ZOUDIO/stabielator/Renders/wit/stabilisator_behuizing_onderkant_(Assembly)_2026-Aug-31_06-38-13PM-000_CustomizedView34296426555.png

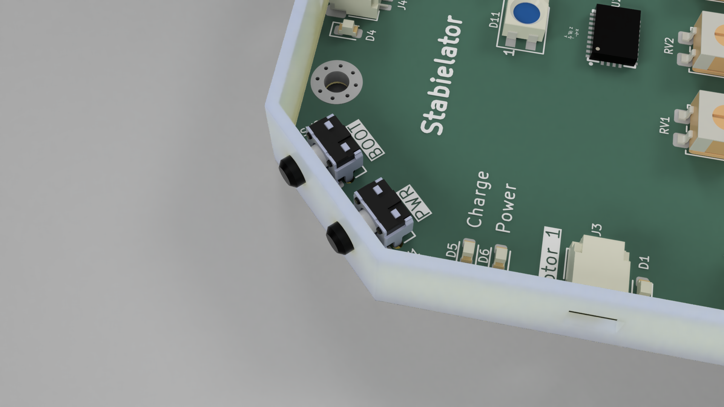
Renders/wit/stabilisator_behuizing_onderkant_(Assembly)_2026-Aug-31_06-38-13PM-000_CustomizedView34296426555.png
