ZOUDIO/stabielator/Renders/zwart/stabilisator_behuizing_onderkant_(Assembly)_2026-Sep-01_04-06-38PM-000_CustomizedView3394416120.png

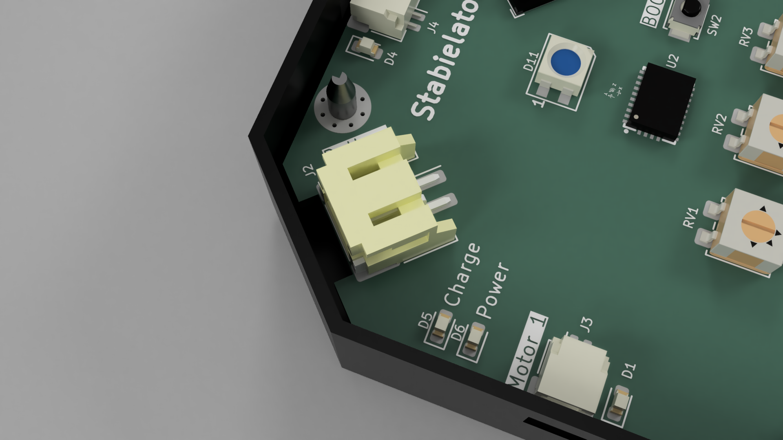
Renders/zwart/stabilisator_behuizing_onderkant_(Assembly)_2026-Sep-01_04-06-38PM-000_CustomizedView3394416120.png
