ZOUDIO/stabielator/Stabielator-Code-V1/README.md

<!--
@file README.md
@brief Startpunt voor de korte Stabielator-documentatie.
@date 2026-11-09
@author ProtoIoT Wietse Houwers
@note Prototype software for evaluation use only.
-->

# Stabielator-documentatie

Firmware **0.5.2** - bijgewerkt op **9 november 2026**.

- [Gebruiksaanwijzing](gebruiksaanwijzing.md): aansluiten, instellen en gebruiken.
- [Uitleg over de code](code-uitleg.md): hoe de software werkt en waar onderdelen staan.
- [Verschillen met het plan van aanpak](verschillen-plan-van-aanpak.md): gemaakte keuzes, aanvullingen en de reden daarvan.
- [Plan van aanpak v0.1](<Plan van Aanpak FW Stabielator v0.1.pdf>): het oorspronkelijke plan van 6 oktober 2026.

De vergelijking is gebaseerd op dit plan van aanpak.
