ZOUDIO/stabielator/Stabielator-Code-V1/Handleiding-Stabielator-firmware-bijwerken.pdf

# Firmware bijwerken

## 1 Open Geavanceerd

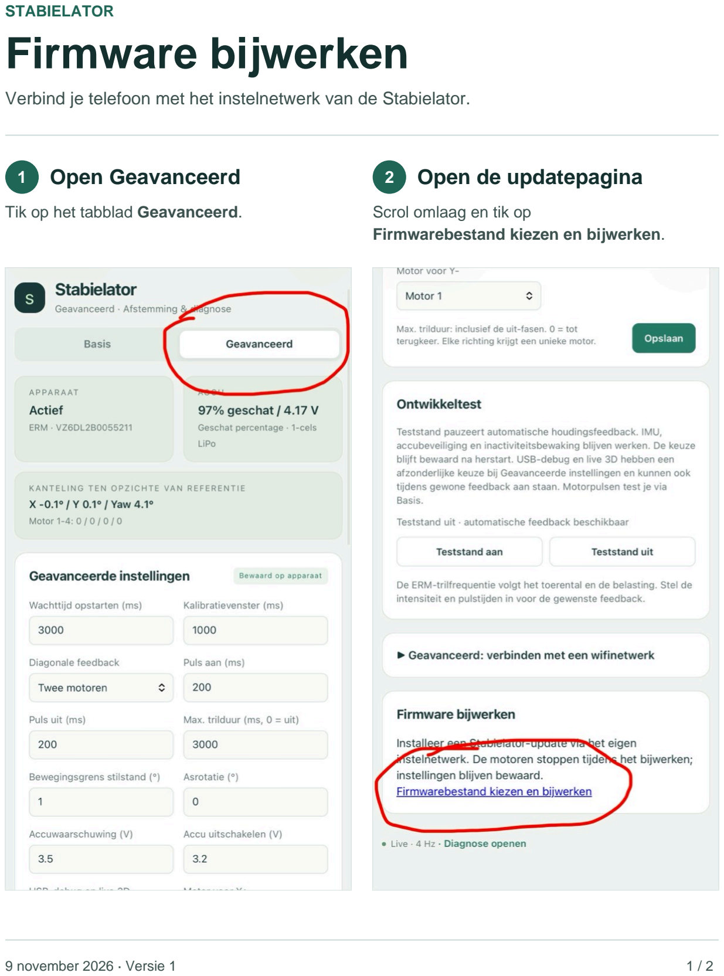
[picture p4: page 1]

STABIELATOR

Verbind je telefoon met het instelnetwerk van de Stabielator.

Tik op het tabblad Geavanceerd.

## 2 Open de updatepagina

Scrol omlaag en tik op
Firmwarebestand kiezen en bijwerken.
9 november 2026 · Versie 1 | 1 / 2

# Firmware bijwerken

## 3 Kies het firmwarebestand

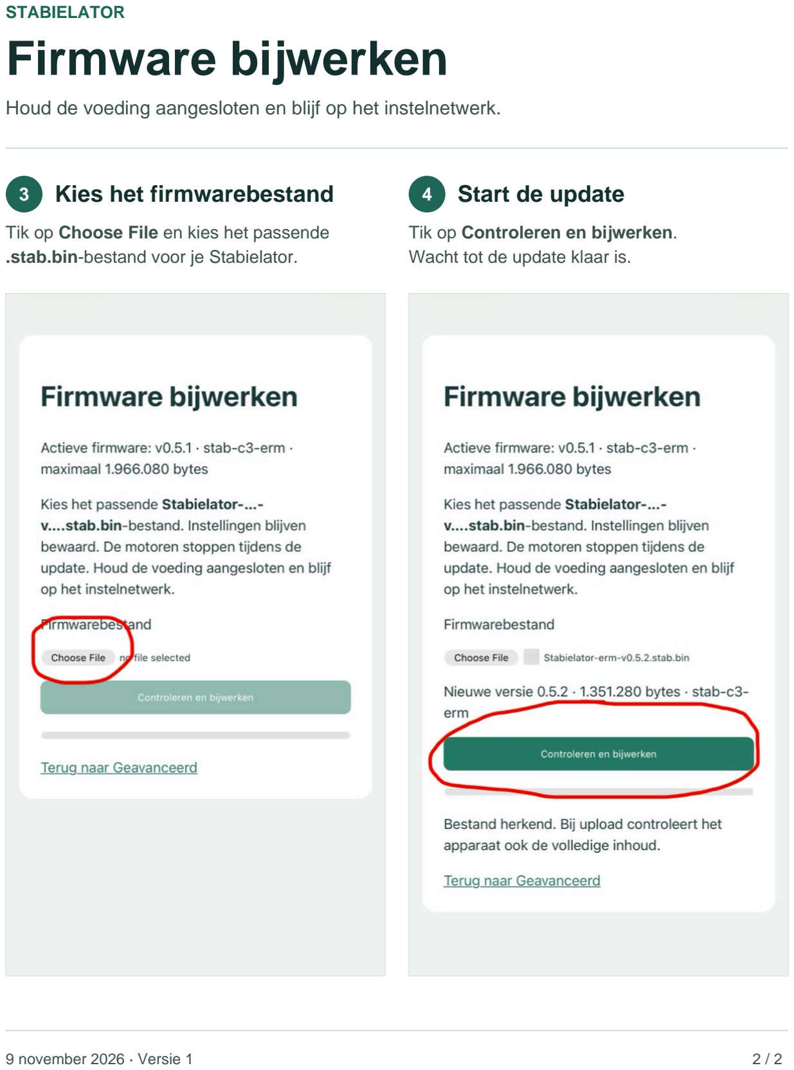
[picture p5: page 2]

STABIELATOR

Houd de voeding aangesloten en blijf op het instelnetwerk.

Tik op Choose File en kies het passende .stab.bin-bestand voor je Stabielator.

## 4 Start de update

Tik op Controleren en bijwerken. Wacht tot de update klaar is.

9 november 2026 · Versie 1 | 2 / 2
