ZOUDIO/stabielator/Renders/wit/83928c85-2367-4ab3-a8cb-f98133e98fb7.PNG

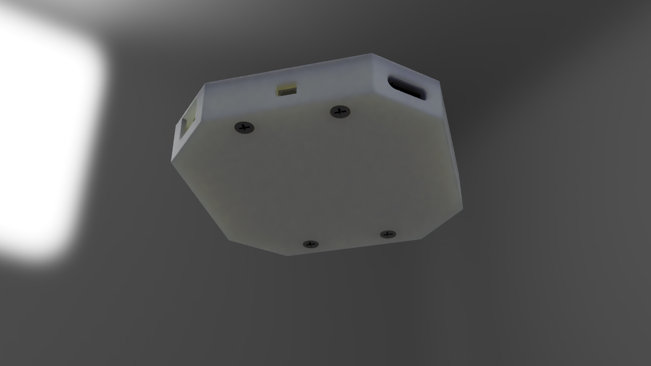
Renders/wit/83928c85-2367-4ab3-a8cb-f98133e98fb7.PNG
