ZOUDIO/stabielator/Renders/zwart/Screenshot 2026-09-01 180344.png

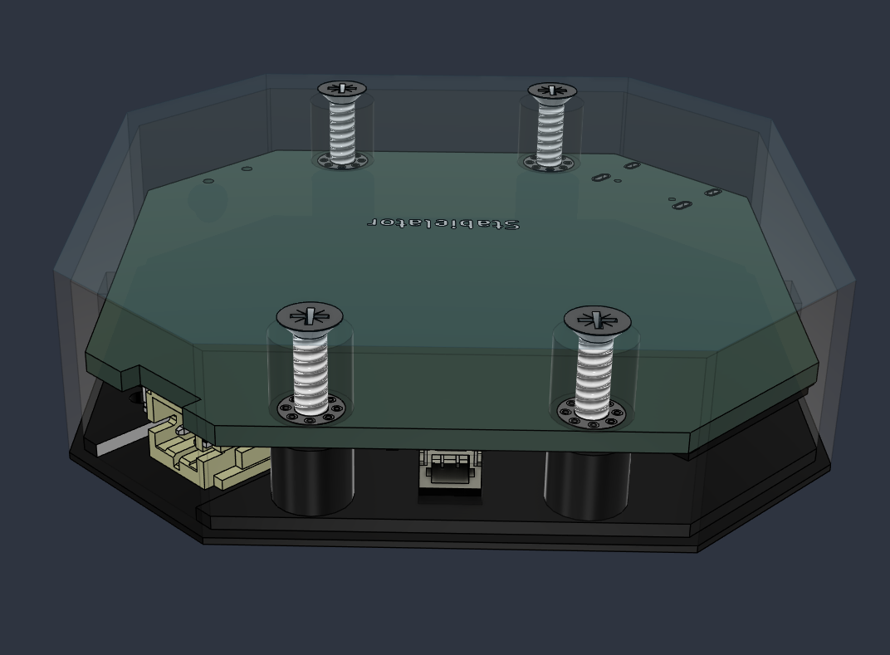
Renders/zwart/Screenshot 2026-09-01 180344.png
