ZOUDIO/stabielator/Behuizing/stabielator_pcb.step

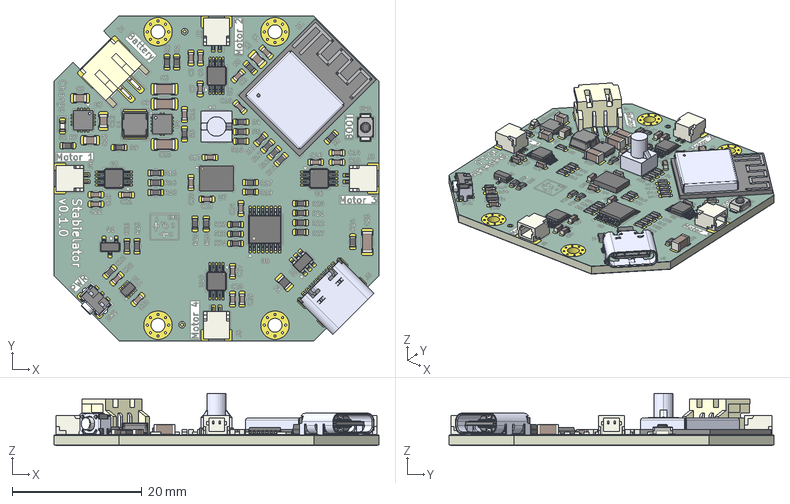
[picture p9: CAD file, 2026-11-09]
Behuizing/stabielator_pcb.step
50.0 x 50.0 x 8.02 mm
R_0603_1608Metric x 32
RGT16
C_0603_1608Metric x 22
TSSOP-10_3x3mm_P0.5mm x 4
TSSOP-16_4.4x5mm_P0.65mm
JST_SH_SM02B-SRSS-TB_1x02-1MP_P1.00mm_Horizontal x 4
C_0805_2012Metric x 4
ESP32-C3-MINI-1-N4
S2B-PH-SM4-TB(LF)(SN)
SOT-583-8
SKRTLAE010
SW_SPST_B3U-1000P
USB4105GFA_USB4105GFA
C_1206_3216Metric x 4
LED_0603_1608Metric
SOT-23
DRC10
SOT-23-6
Fuse_0805_2012Metric
L_Bourns-SRN4018
LED_RGB_Wuerth-PLCC4_3.2x2.8mm_150141M173100
LGA_28_52x38mm_P05mm
stabielator_copper
stabielator_silkscreen x 2
stabielator_soldermask x 2
stabielator_PCB
