ZOUDIO/stabielator/Behuizing/stabilisator_behuizing_knopje.step

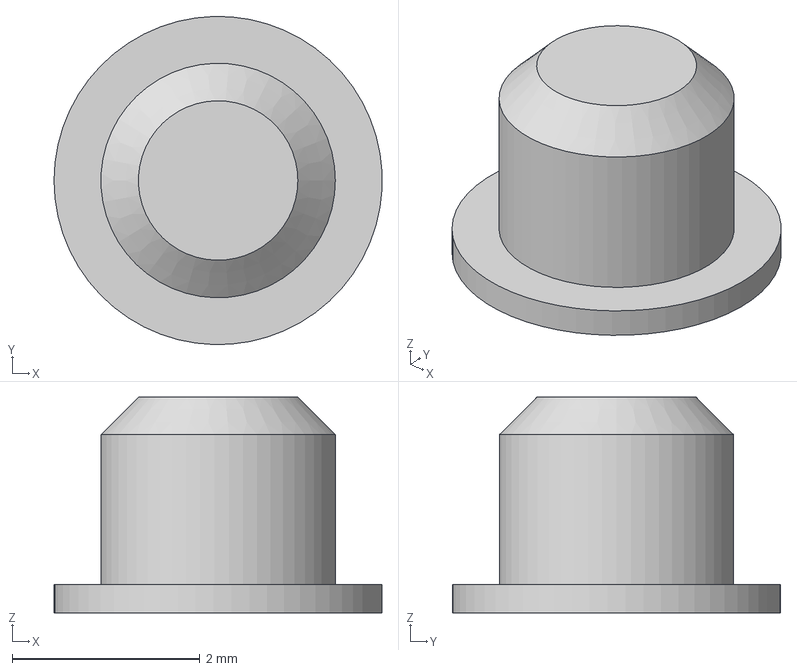
[picture p11: CAD file, 2026-09-01]
Behuizing/stabilisator_behuizing_knopje.step
3.50 x 3.50 x 2.30 mm
