ZOUDIO/stabielator/Behuizing/stabilisator_behuizing_onderkant.step

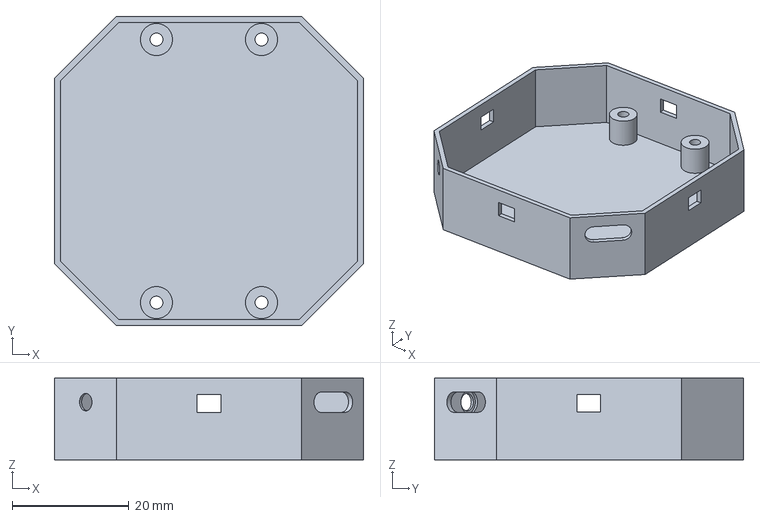
[picture p12: CAD file, 2026-09-01]
Behuizing/stabilisator_behuizing_onderkant.step
53.0 x 53.0 x 14.0 mm
