ZOUDIO/stabielator/Behuizing/stabilisator_behuizing_bovenkant.step

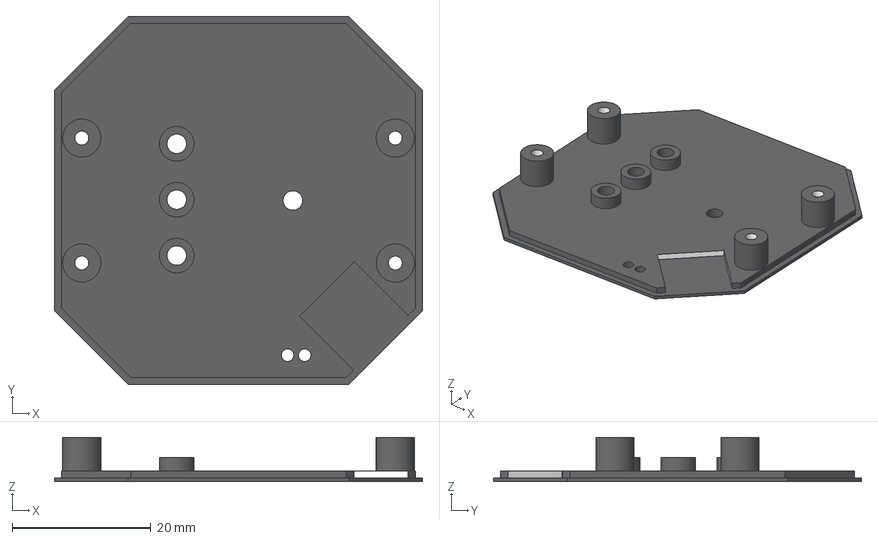
[picture p13: CAD file, 2026-09-01]
Behuizing/stabilisator_behuizing_bovenkant.step
53.0 x 53.0 x 6.38 mm
