ZOUDIO/stabielator/Behuizing/stabilisator_behuizing_bovenkant_TEST.dxf

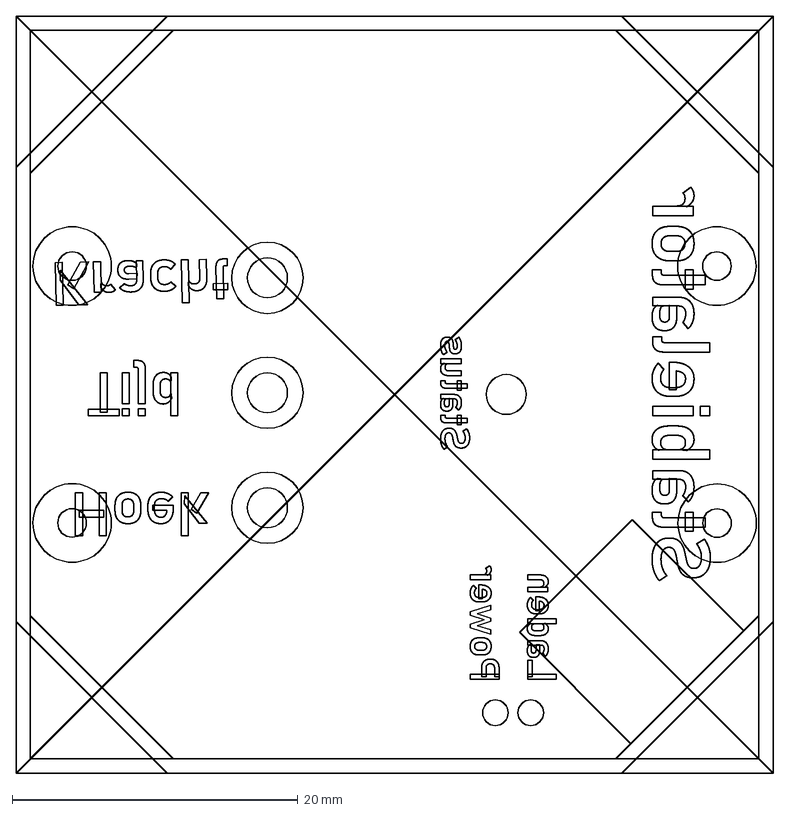
[picture p14: CAD file, 2026-09-01]
Behuizing/stabilisator_behuizing_bovenkant_TEST.dxf
53.0 x 53.0 mm
