ZOUDIO/stabielator/(list of files, cad)

Other CAD files:
Behuizing/stabilisator_behuizing (Assembly).f3z
