ZOUDIO/stabielator/Renders/wit/stabilisator_behuizing_onderkant_(Assembly)_2026-Aug-31_06-37-58PM-000_CustomizedView13024559189.png

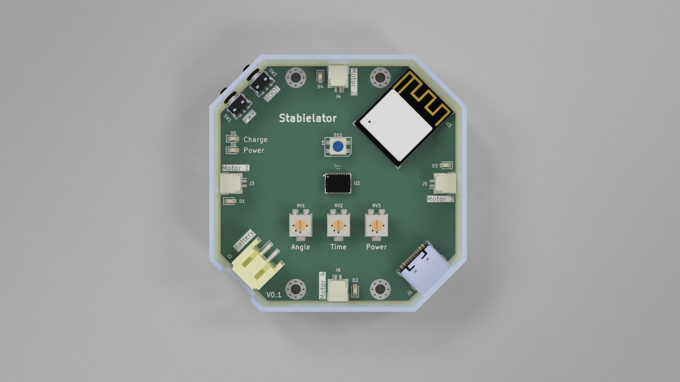
Renders/wit/stabilisator_behuizing_onderkant_(Assembly)_2026-Aug-31_06-37-58PM-000_CustomizedView13024559189.png
