ZOUDIO/stabielator/Renders/wit/stabilisator_behuizing_onderkant_(Assembly)_2026-Aug-31_06-38-52PM-000_CustomizedView15293623472.png

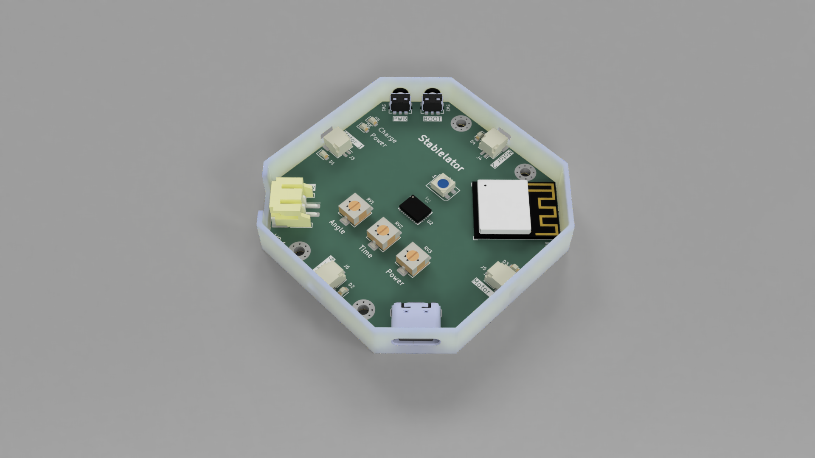
Renders/wit/stabilisator_behuizing_onderkant_(Assembly)_2026-Aug-31_06-38-52PM-000_CustomizedView15293623472.png
