ZOUDIO/stabielator/Renders/wit/stabilisator_behuizing_onderkant_(Assembly)_2026-Aug-31_06-39-25PM-000_CustomizedView20866006980.png

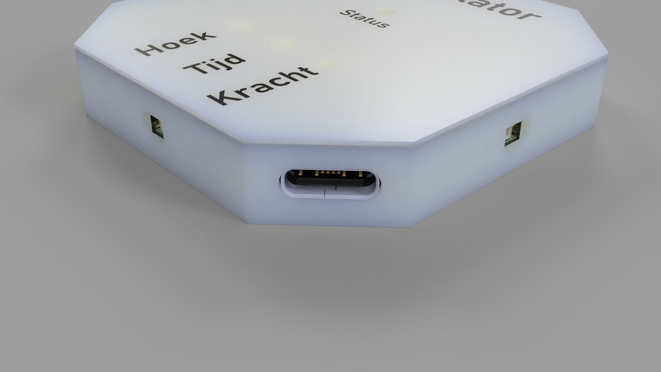
Renders/wit/stabilisator_behuizing_onderkant_(Assembly)_2026-Aug-31_06-39-25PM-000_CustomizedView20866006980.png
