ZOUDIO/stabielator/Renders/wit/stabilisator_behuizing_onderkant_(Assembly)_2026-Aug-31_06-40-00PM-000_CustomizedView354775007.png

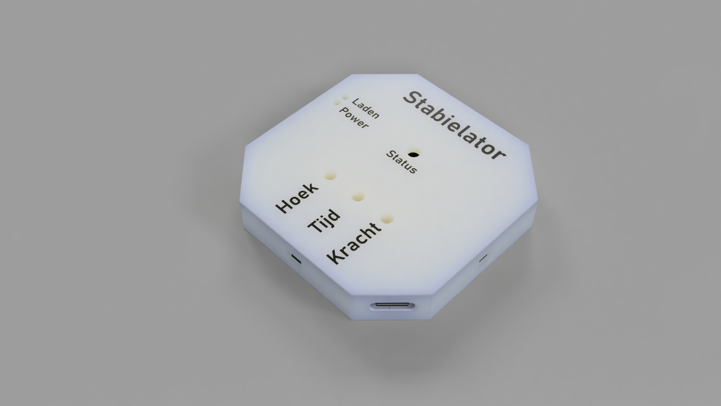
Renders/wit/stabilisator_behuizing_onderkant_(Assembly)_2026-Aug-31_06-40-00PM-000_CustomizedView354775007.png
