ZOUDIO/stabielator/Renders/zwart/stabilisator_behuizing_onderkant_(Assembly)_2026-Sep-01_04-05-23PM-000_CustomizedView11902049312.png

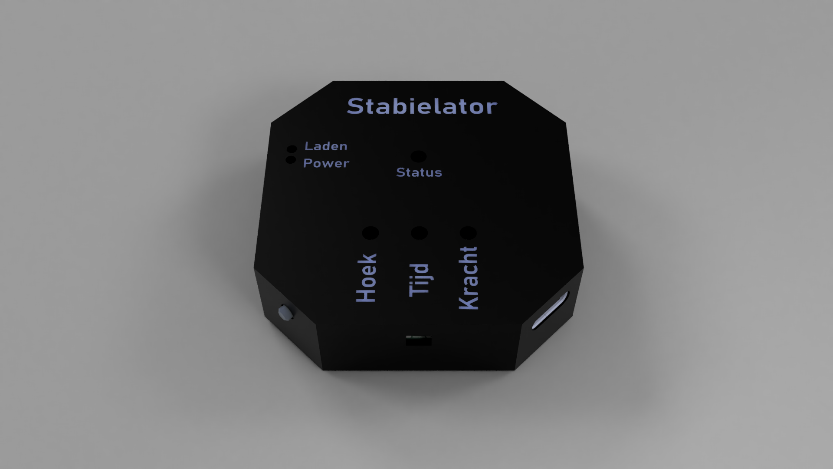
Renders/zwart/stabilisator_behuizing_onderkant_(Assembly)_2026-Sep-01_04-05-23PM-000_CustomizedView11902049312.png
