ZOUDIO/stabielator/Renders/zwart/stabilisator_behuizing_onderkant_(Assembly)_2026-Sep-01_04-05-56PM-000_CustomizedView1753548943.png

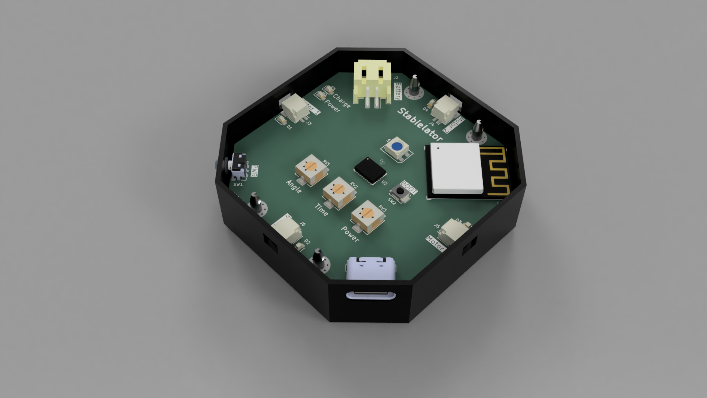
Renders/zwart/stabilisator_behuizing_onderkant_(Assembly)_2026-Sep-01_04-05-56PM-000_CustomizedView1753548943.png
