ZOUDIO/stabielator/Renders/zwart/stabilisator_behuizing_onderkant_(Assembly)_2026-Sep-01_04-06-17PM-000_CustomizedView27367255653.png

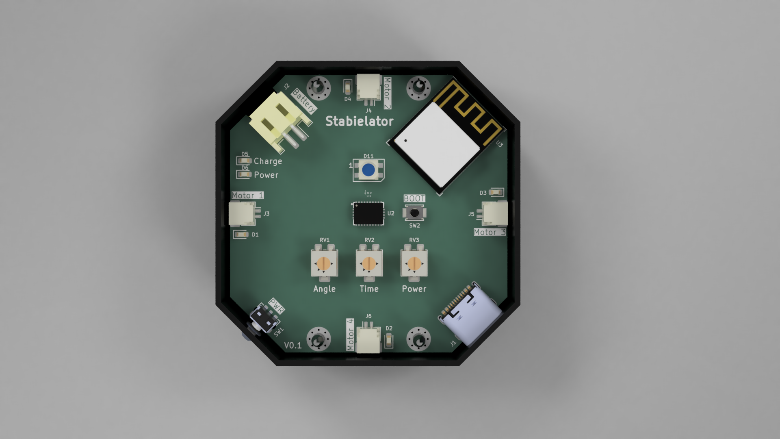
Renders/zwart/stabilisator_behuizing_onderkant_(Assembly)_2026-Sep-01_04-06-17PM-000_CustomizedView27367255653.png
