ZOUDIO/stabielator/Stabielator-Code-V1/src/wifi_events.h

/**
 * @file wifi_events.h
 * @brief Interface voor taakveilige registratie en verwerking van WiFi-events.
 * @date 2026-11-08
 * @author ProtoIoT Wietse Houwers
 * @note Prototype software for evaluation use only.
 */
#pragma once
void beginWifiEventLogging();
void processWifiEventLog();
