ZOUDIO/stabielator/(commit log)

2026-08-31 Concept design V0.1
    PCB en behuizing conceptdesign
    t.b.v. Feedback klant
    [JS102011SAQN.step, SKRTLAE010.step, TYPE-C 16PIN.STEP, stabielator.kicad_pcb, stabielator.kicad_sch, stabielator.step]
2026-09-01 Add battery compartment
    Add internal battery space 5.5mm*39mm*50mm
    Replace boot button for top side
    Change colours
    [stabielator.kicad_pcb, stabielator.kicad_sch, stabielator.step, stabielator_pcb.step, stabilisator_behuizing (Assembly).f3z, stabilisator_behuizing_bovenkant.step, stabilisator_behuizing_bovenkant_TEST.dxf, stabilisator_behuizing_knopje.step]
2026-09-07 Concept Schematic
    [BQ24074RGTR.step, haptic.kicad_sch, power.kicad_sch, staabielator3dprint.step, stabielator.kicad_pcb, stabielator.kicad_sch]
2026-09-08 Finished for review
    [haptic.kicad_sch, power.kicad_sch, stabielator.kicad_pcb, stabielator.kicad_sch]
2026-09-08 Opschonen / hernoemen / verplaatsen
    [BQ24074RGTR.step, JS102011SAQN.step, SKRTLAE010.step, TYPE-C 16PIN.STEP, haptic.kicad_sch, power.kicad_sch, staabielator3dprint.step, stabielator.kicad_pcb]
2026-09-09 Review schematic
    Fix errors / add improvements
    Add gitignore file
    [haptic.kicad_sch, logic.kicad_sch, power.kicad_sch, stabielator.kicad_sch]
2026-09-09 Put the drivers on 3V3
    [logic.kicad_sch]
2026-09-11 Hopelijk definitief schema
    Voornamelijk voeding opnieuw gemaakt;
    Vervangen voor een buck boost systeem.
    [USB4105-GF-A.STEP, logic.kicad_sch, power.kicad_sch, stabielator.kicad_pcb, stabielator.kicad_sch]
2026-09-11 Change gitignore
    [BillOfMaterialsV0.1.csv]
2026-09-11 Edit BOM
    Add manufacturer
    Add partnumber
    [logic.kicad_sch, power.kicad_sch, stabielator.kicad_sch]
2026-09-11 Reannotated schematic based on component placement
    [logic.kicad_sch, power.kicad_sch, stabielator.kicad_pcb, stabielator.kicad_sch]
2026-09-18 Finish concept layout and routing
    [logic.kicad_sch, power.kicad_sch, stabielator.kicad_pcb]
2026-09-20 Geographical reannotation
    [BillOfMaterialsV0.1.csv, logic.kicad_sch, power.kicad_sch, stabielator.kicad_pcb, stabielator.kicad_sch]
2026-09-20 Activate thermal reliefs (excluding buck/charge)
    [stabielator.kicad_pcb]
2026-09-20 change size of logic tab A4->A3 and create production files
    Gerbers generated for JLCpcb, settings for other producer are unknown
    [BOM-stabielator.csv, logic.kicad_sch, power.kicad_sch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]
2026-09-29 Ready for production
    Small readability and producability optimizations
    [BillOfMaterialsV0.1.csv, USB4105-GF-A.STEP, logic.kicad_sch, power.kicad_sch, stabielator.kicad_pcb, stabielator.kicad_sch]
2026-09-30 Feedback Elect
    - Thermal reliefs toegepast op een aantal extra onderdelen
    - U7 (LGA-28) footprint pads + pasta/masker aangepast (80% pasta dekking aangeraden door fabrikant)
    - Algemene soldeer masker expansie op 0 gezet
    - 2x 0.5mm fiducial toegevoegd
    [logic.kicad_sch, stabielator.kicad_pcb, stabielator.kicad_sch]
2026-11-09 Add Stabielator-Code-V1 and update pcb STEP
