ZOUDIO/stabielator/PCB/stabielator.kicad_pcb

## KiCad design PCB/stabielator.kicad_pcb (2026-09-30)

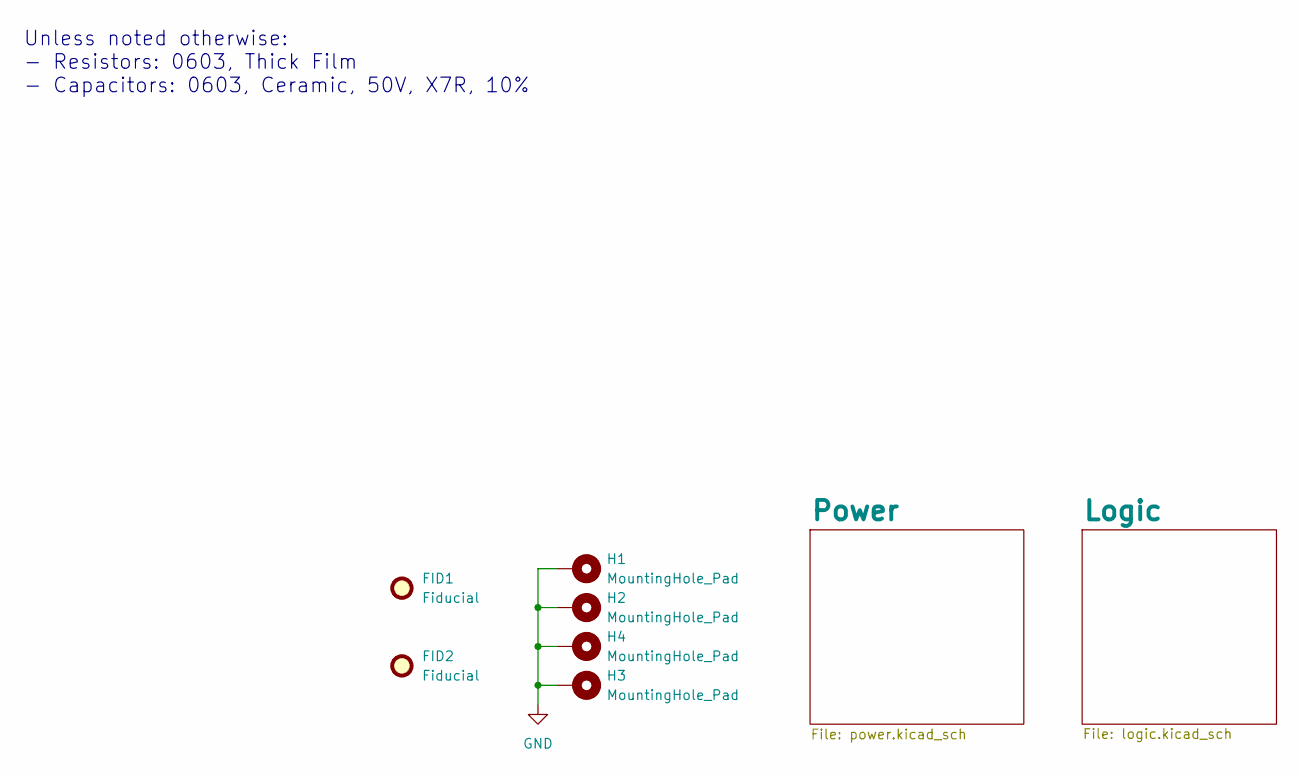
[picture p1: schematic stabielator.kicad_sch, ${Project_name}]

Parts:
FID1, FID2: Fiducial; Fiducial_0.5mm_Mask1mm
H1, H2, H3, H4: MountingHole_Pad; MountingHole_2.2mm_M2_Pad_Via; Digikey nvt

Connections:
GND: H1.1 (1_1), H2.1 (1_1), H3.1 (1_1), H4.1 (1_1); also elsewhere on the board

Notes on the sheet:
Unless noted otherwise: - Resistors: 0603, Thick Film - Capacitors: 0603, Ceramic, 50V, X7R, 10%

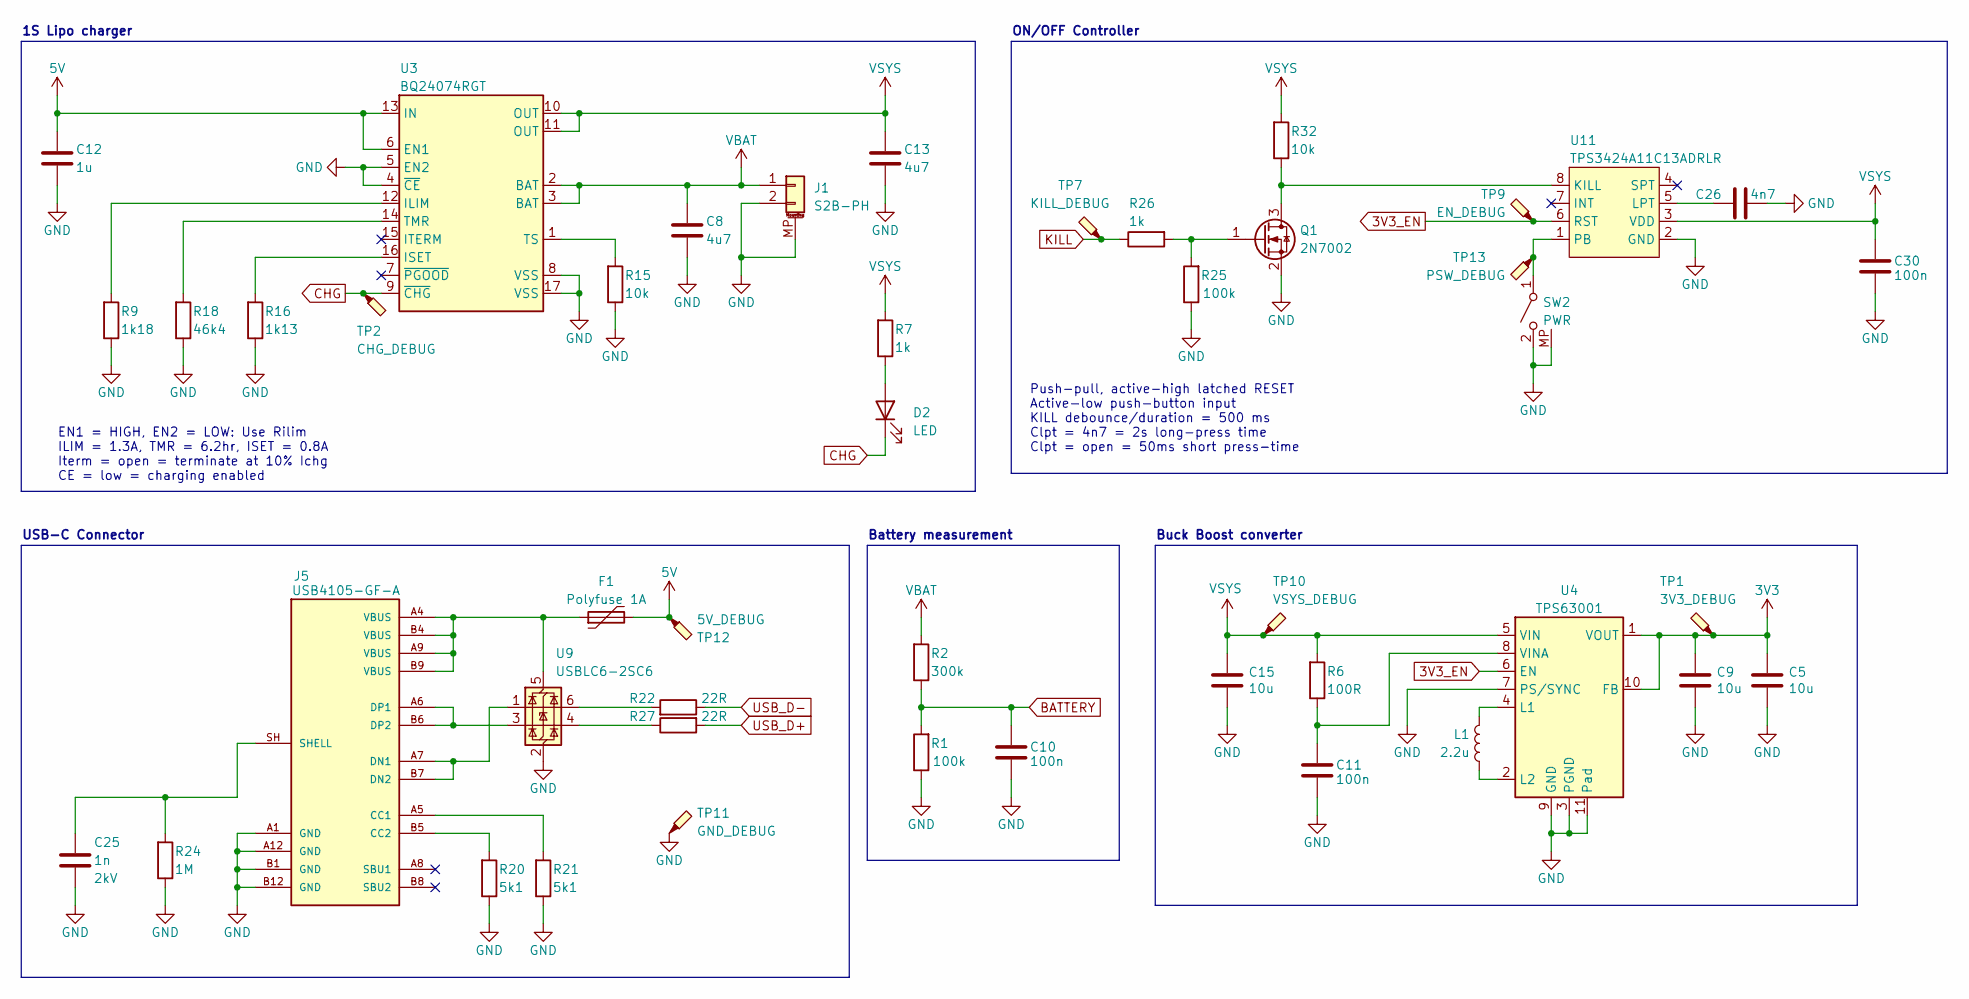
[picture p2: schematic power.kicad_sch, ${Project_name}]

Parts:
C5, C9, C15: 10u; C_1206_3216Metric; Partnumber CGA5L1X7R1C106K160AC; Digikey 445-12902-1-ND
C8, C13: 4u7; C_0805_2012Metric; Partnumber GRM21BR71C475KE51L; Digikey 490-14466-1-ND
C10, C11, C30: 100n; C_0603_1608Metric; Partnumber C0603C104K5RACTU; Digikey 399-C0603C104K5RACTUCT-ND
C12: 1u; C_0805_2012Metric; Partnumber GRM21BR71C105KA01L; Digikey 490-1691-1-ND
C25: 1n; C_1206_3216Metric; Voltage 2kV; Partnumber C1206C102KGRACTU; Digikey 399-C1206C102KGRACTUCT-ND
C26: 4n7; C_0603_1608Metric; Partnumber C1608X7R1H472K080AE; Digikey 445-173690-1-ND
D2: LED; LED_0603_1608Metric; Partnumber 150060RS55040; Digikey 732-12015-1-ND
F1: Polyfuse 1A; Fuse_0805_2012Metric; Partnumber 0ZCK0100FF2E; Digikey 5923-0ZCK0100FF2ECT-ND
J1: S2B-PH; JST_PH_S2B-PH-SM4-TB_1x02-1MP_P2.00mm_Horizontal; Partnumber S2B-PH-SM4-TB; Digikey 455-S2B-PH-SM4-TBCT-ND
J5: USB4105-GF-A; USB_C_Receptacle_Palconn_UTC16-G; Partnumber USB4105-GF-A; Digikey 2073-USB4105-GF-ACT-ND
L1: 2.2u; L_Bourns-SRN4018; Partnumber SRN4018-2R2M; Digikey SRN4018-2R2MCT-ND
Q1: 2N7002; SOT-23; Partnumber 2N7002; Digikey 2N7002NCT-ND
R1, R25: 100k; R_0603_1608Metric; Partnumber RC0603FR-07100KL; Digikey 311-100KHRCT-ND
R2: 300k; R_0603_1608Metric; Partnumber RC0603FR-07300KL; Digikey 311-300KHRTR-ND
R6: 100R; R_0603_1608Metric; Partnumber RC0603FR-07100RL; Digikey 311-100HRCT-ND
R7, R26: 1k; R_0603_1608Metric; Partnumber RC0603FR-071KL; Digikey 311-1.00KHRCT-ND
R9: 1k18; R_0603_1608Metric; Partnumber RC0603FR-071K18L; Digikey 311-1.18KHRCT-ND
R15, R32: 10k; R_0603_1608Metric; Partnumber RC0603FR-0710KL; Digikey 311-10.0KHRCT-ND
R16: 1k13; R_0603_1608Metric; Partnumber RC0603FR-071K13L; Digikey 311-1.13KHRCT-ND
R18: 46k4; R_0603_1608Metric; Partnumber RC0603FR-0746K4L; Digikey 311-46.4KHRCT-ND
R20, R21: 5k1; R_0603_1608Metric; Partnumber RC0603FR-075K1L; Digikey 311-5.10KHRTR-ND
R22, R27: 22R; R_0603_1608Metric; Partnumber RC0603FR-0722RL; Digikey 311-22.0HRTR-ND
R24: 1M; R_0603_1608Metric; Partnumber RC0603FR-071ML; Digikey 311-1.00MHRCT-ND
SW2: PWR; SW_Push_1P1T-MP_NO_Horizontal_Alps_SKRTLAE010; Partnumber SKRTLAE010; Digikey 4809-SKRTLAE010CT-ND
TP1: 3V3_DEBUG; TestPoint_Pad_D1.0mm; Digikey nvt
TP2: CHG_DEBUG; TestPoint_Pad_D1.0mm; Digikey nvt
TP7: KILL_DEBUG; TestPoint_Pad_D1.0mm; Digikey nvt
TP9: EN_DEBUG; TestPoint_Pad_D1.0mm; Digikey nvt
TP10: VSYS_DEBUG; TestPoint_Pad_D1.0mm; Digikey nvt
TP11: GND_DEBUG; TestPoint_Pad_D1.0mm; Digikey nvt
TP12: 5V_DEBUG; TestPoint_Pad_D1.0mm; Digikey nvt
TP13: PSW_DEBUG; TestPoint_Pad_D1.0mm; Digikey nvt
U3: BQ24074RGT; VQFN-16-1EP_3x3mm_P0.5mm_EP1.6x1.6mm_ThermalVias; Partnumber BQ24074RGTR; Digikey 296-38873-1-ND
U4: TPS63001; Texas_DRC0010J_ThermalVias; Partnumber TPS63001DRCR; Digikey 296-19643-1-ND
U9: USBLC6-2SC6; SOT-23-6; Partnumber USBLC6-2SC6; Digikey 497-5235-2-ND
U11: TPS3424A11C13ADRLR; SOT-583-8; Partnumber TPS3424A11C13ADRLR; Digikey 296-TPS3424A11C13ADRLRCT-ND

Connections:
3V3: C5.1, C9.1, TP1.1 (1_1), U4.1 (VOUT), U4.10 (FB); also elsewhere on the board
3V3_EN: TP9.1 (1_1), U4.6 (EN), U11.6 (RST)
5V: C12.1, F1.2, TP12.1 (1_1), U3.6 (EN1), U3.13 (IN)
BATTERY: C10.1, R1.1, R2.2; also elsewhere on the board
CHG: D2.1 (K), TP2.1 (1_1), U3.9 (~CHG)
GND: C5.2, C8.2, C9.2, C10.2, C11.2, C12.2, C13.2, C15.2, C25.2, C26.2, C30.2, J1.2, J1.MP (MountPin), J5.A1 (GND), J5.A12 (GND), J5.B1 (GND), J5.B12 (GND), Q1.2 (S), R1.2, R9.2, R15.2, R16.2, R18.2, R20.2, R21.2, R24.2, R25.2, SW2.2 (B), SW2.MP, TP11.1 (1_1), U3.4 (~CE), U3.5 (EN2), U3.8 (VSS), U3.17 (VSS), U4.3 (PGND), U4.7 (PS/SYNC), U4.9 (GND), U4.11 (PGND), U9.2 (GND), U11.2 (GND); also elsewhere on the board
KILL: R26.2, TP7.1 (1_1); also elsewhere on the board
unnamed: D2.2 (A), R7.2
unnamed: J5.A5 (CC1), R21.1
unnamed: J5.B5 (CC2), R20.1
unnamed: J5.A7 (DN1), J5.B7 (DN2), U9.1 (I/O1)
unnamed: J5.A6 (DP1), J5.B6 (DP2), U9.3 (I/O2)
unnamed: C25.1, J5.SH (SHELL), R24.1
unnamed: Q1.3 (D), R32.2, U11.8 (KILL)
unnamed: Q1.1 (G), R25.1, R26.1
unnamed: R22.1, U9.6 (I/O1)
unnamed: R27.2, U9.4 (I/O2)
unnamed: SW2.1 (A), TP13.1 (1_1), U11.1 (PB)
unnamed: R9.1, U3.12 (ILIM)
unnamed: R16.1, U3.16 (ISET)
unnamed: R18.1, U3.14 (TMR)
unnamed: R15.1, U3.1 (TS)
unnamed: L1.1, U4.4 (L1)
unnamed: L1.2, U4.2 (L2)
unnamed: C11.1, R6.2, U4.8 (VINA)
unnamed: F1.1, J5.A4 (VBUS), J5.A9 (VBUS), J5.B4 (VBUS), J5.B9 (VBUS), U9.5 (VBUS)
unnamed: C26.1, U11.5 (LPT)
USB_D+: R27.1; also elsewhere on the board
USB_D-: R22.2; also elsewhere on the board
VBAT: C8.1, J1.1, R2.1, U3.2 (BAT), U3.3 (BAT)
VSYS: C13.1, C15.1, C30.1, R6.1, R7.1, R32.1, TP10.1 (1_1), U3.10 (OUT), U3.11 (OUT), U4.5 (VIN), U11.3 (VDD)

Notes on the sheet:
1S Lipo charger
USB-C Connector
Buck Boost converter
Push-pull, active-high latched RESET Active-low push-button input KILL debounce/duration = 500 ms Clpt = 4n7 = 2s long-press time Clpt = open = 50ms short press-time
EN1 = HIGH, EN2 = LOW: Use Rilim ILIM = 1.3A, TMR = 6.2hr, ISET = 0.8A Iterm = open = terminate at 10% Ichg CE = low = charging enabled
Battery measurement
ON/OFF Controller

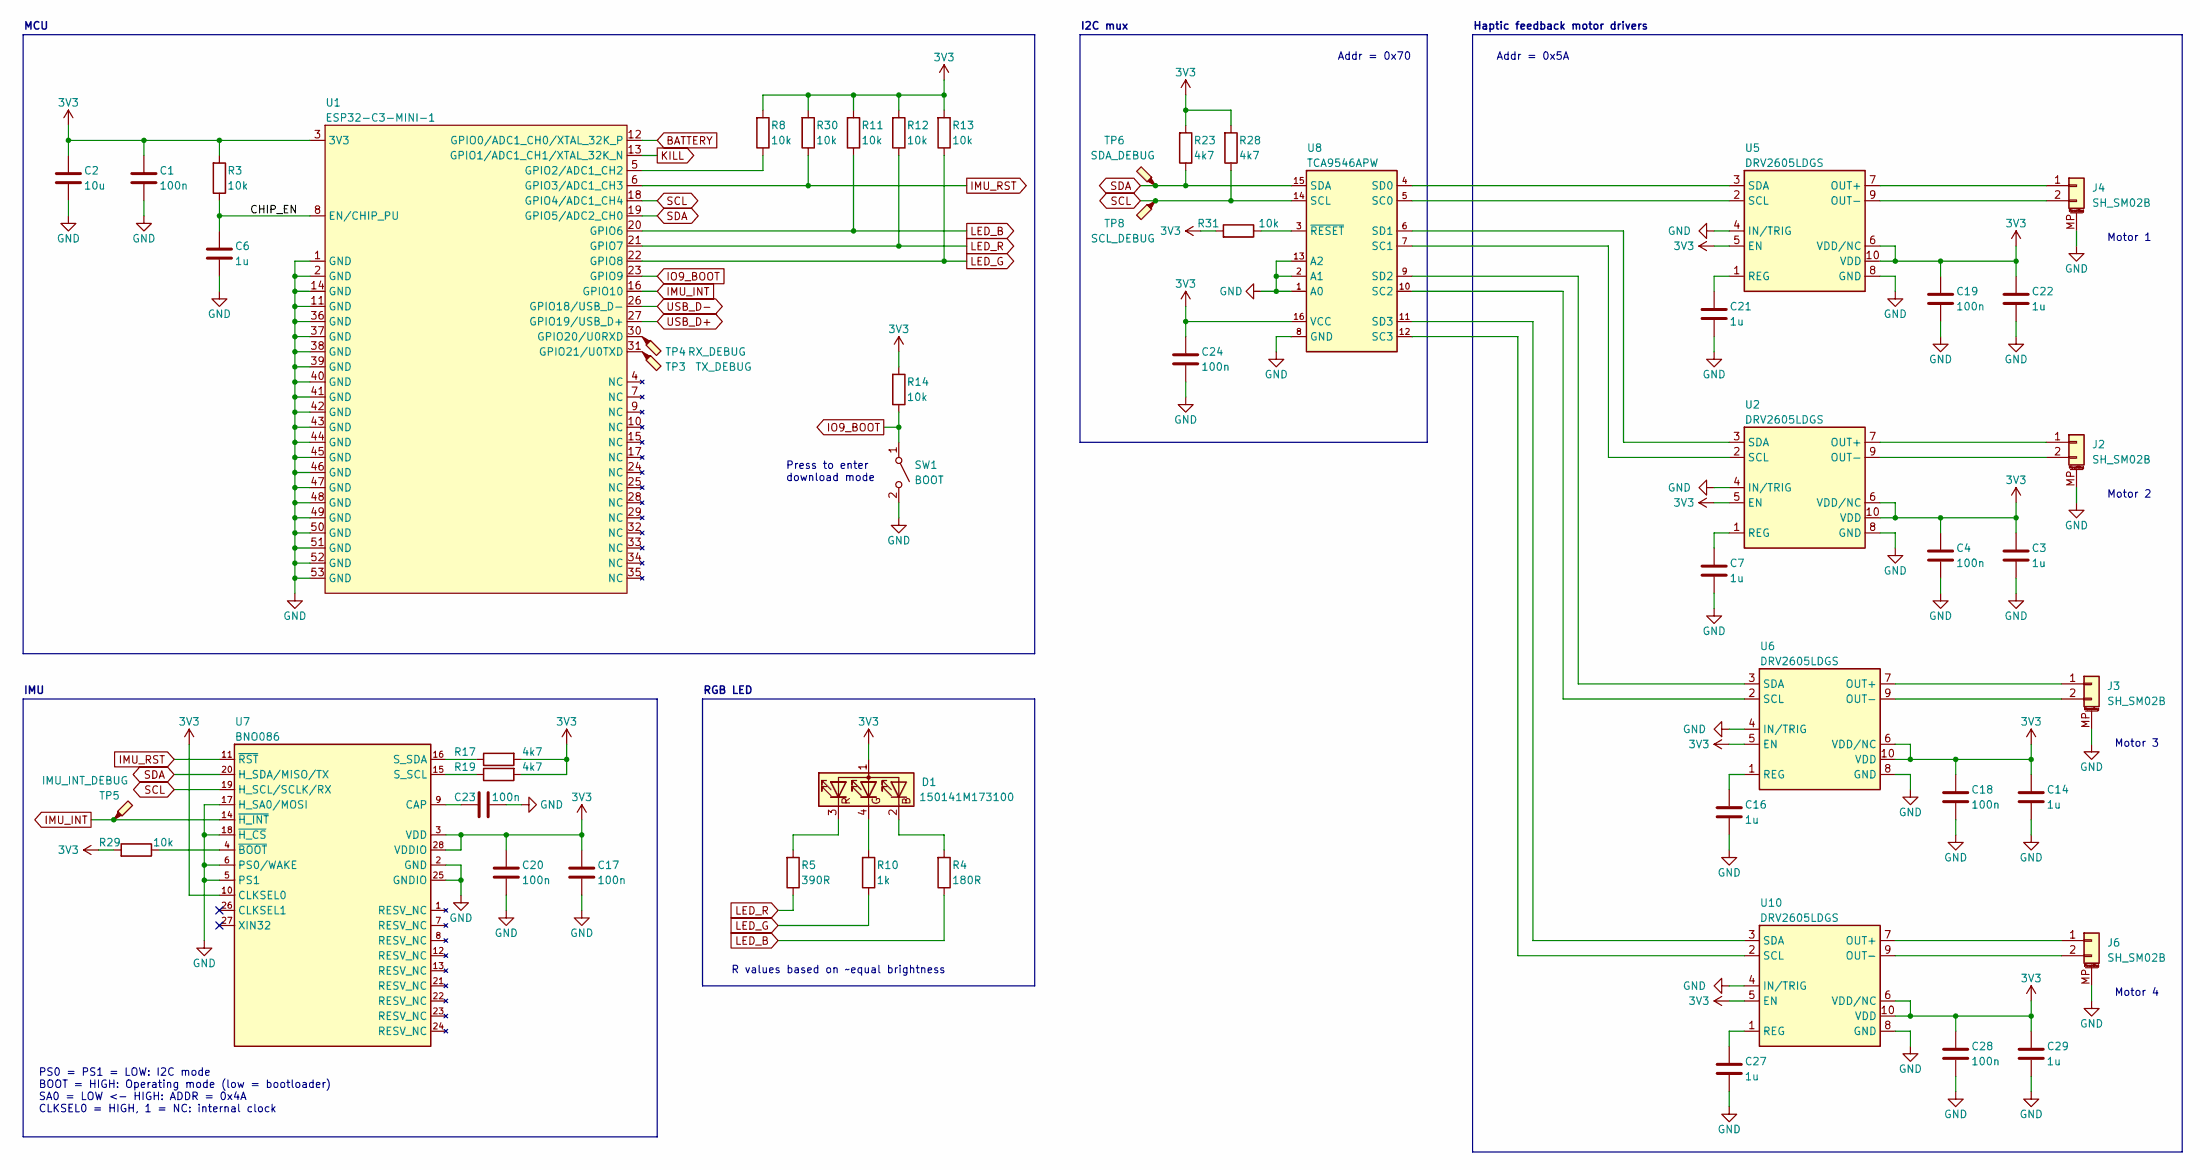
[picture p3: schematic logic.kicad_sch, ${Project_name}]

Parts:
C1, C4, C17, C18, C19, C20, C23, C24, C28: 100n; C_0603_1608Metric; Partnumber C0603C104K5RACTU; Digikey 399-C0603C104K5RACTUCT-ND
C2: 10u; C_0805_2012Metric; Partnumber CL21B106KOQNNNE; Digikey 1276-2872-1-ND
C3, C6, C7, C14, C16, C21, C22, C27, C29: 1u; C_0603_1608Metric; Partnumber C1608X7R1C105K080AC; Digikey 445-1604-1-ND
D1: 150141M173100; LED_RGB_Wuerth-PLCC4_3.2x2.8mm_150141M173100; Partnumber 150141M173100; Digikey 732-4998-1-ND
J2, J3, J4, J6: SH_SM02B; JST_SH_SM02B-SRSS-TB_1x02-1MP_P1.00mm_Horizontal; Partnumber SM02B-SRSS-TB; Digikey 455-SM02B-SRSS-TBCT-ND
R3, R8, R11, R12, R13, R14, R29, R30, R31: 10k; R_0603_1608Metric; Partnumber RC0603FR-0710KL; Digikey 311-10.0KHRCT-ND
R4: 180R; R_0603_1608Metric; Partnumber RC0603FR-07180RL; Digikey 311-180HRCT-ND
R5: 390R; R_0603_1608Metric; Partnumber RC0603FR-07390RL; Digikey 311-390HRCT-ND
R10: 1k; R_0603_1608Metric; Partnumber RC0603FR-071KL; Digikey 311-1.00KHRCT-ND
R17, R19, R23, R28: 4k7; R_0603_1608Metric; Partnumber RC0603FR-074K7L; Digikey 311-4.70KHRCT-ND
SW1: BOOT; SW_SPST_B3U-1000P; Partnumber B3U-1000P; Digikey SW1020CT-ND
TP3: TX_DEBUG; TestPoint_Pad_D1.0mm; Digikey nvt
TP4: RX_DEBUG; TestPoint_Pad_D1.0mm; Digikey nvt
TP5: IMU_INT_DEBUG; TestPoint_Pad_D1.0mm; Digikey nvt
TP6: SDA_DEBUG; TestPoint_Pad_D1.0mm; Digikey nvt
TP8: SCL_DEBUG; TestPoint_Pad_D1.0mm; Digikey nvt
U1: ESP32-C3-MINI-1; Partnumber ESP32-C3-MINI-1-N4; Digikey 5407-ESP32-C3-MINI-1-N4CT-ND
U2, U5, U6, U10: DRV2605LDGS; TSSOP-10_3x3mm_P0.5mm; Partnumber DRV2605LDGSR; Digikey 296-40032-1-ND
U7: BNO086; LGA-28; Partnumber BNO086; Digikey 1888-BNO086CT-ND
U8: TCA9546APW; TSSOP-16_4.4x5mm_P0.65mm; Partnumber TCA9546APWR; Digikey 4518-TCA9546APWRCT-ND

Connections:
3V3: C1.1, C2.1, C3.1, C4.1, C14.1, C17.1, C18.1, C19.1, C20.1, C22.1, C24.1, C28.1, C29.1, D1.1 (A), R3.1, R8.1, R11.1, R12.1, R13.1, R14.1, R17.1, R19.1, R23.1, R28.1, R29.1, R30.1, R31.1, U1.3 (3V3), U2.5 (EN), U2.6 (VDD/NC), U2.10 (VDD), U5.5 (EN), U5.6 (VDD/NC), U5.10 (VDD), U6.5 (EN), U6.6 (VDD/NC), U6.10 (VDD), U7.3 (VDD), U7.10 (CLKSEL0), U7.28 (VDDIO), U8.16 (VCC), U10.5 (EN), U10.6 (VDD/NC), U10.10 (VDD); also elsewhere on the board
/Logic/CHIP_EN: C6.1, R3.2, U1.8 (EN/CHIP_PU)
BATTERY: U1.12 (GPIO0/ADC1_CH0/XTAL_32K_P); also elsewhere on the board
GND: C1.2, C2.2, C3.2, C4.2, C6.2, C7.2, C14.2, C16.2, C17.2, C18.2, C19.2, C20.2, C21.2, C22.2, C23.1, C24.2, C27.2, C28.2, C29.2, J2.MP (MountPin), J3.MP (MountPin), J4.MP (MountPin), J6.MP (MountPin), SW1.2 (B), U1.1 (GND), U1.2 (GND), U1.11 (GND), U1.14 (GND), U1.36 (GND), U1.37 (GND), U1.38 (GND), U1.39 (GND), U1.40 (GND), U1.41 (GND), U1.42 (GND), U1.43 (GND), U1.44 (GND), U1.45 (GND), U1.46 (GND), U1.47 (GND), U1.48 (GND), U1.49 (GND), U1.50 (GND), U1.51 (GND), U1.52 (GND), U1.53 (GND), U2.4 (IN/TRIG), U2.8 (GND), U5.4 (IN/TRIG), U5.8 (GND), U6.4 (IN/TRIG), U6.8 (GND), U7.2 (GND), U7.5 (PS1), U7.6 (PS0/WAKE), U7.17 (H_SA0/MOSI), U7.18 (~H_CS), U7.25 (GNDIO), U8.1 (A0), U8.2 (A1), U8.8 (GND), U8.13 (A2), U10.4 (IN/TRIG), U10.8 (GND); also elsewhere on the board
IMU_INT: TP5.1 (1_1), U1.16 (GPIO10), U7.14 (~H_INT)
IMU_RST: R30.2, U1.6 (GPIO3/ADC1_CH3), U7.11 (~RST)
IO9_BOOT: R14.2, SW1.1 (A), U1.23 (GPIO9)
KILL: U1.13 (GPIO1/ADC1_CH1/XTAL_32K_N); also elsewhere on the board
LED_B: R4.2, R11.2, U1.20 (GPIO6)
LED_G: R10.2, R13.2, U1.22 (GPIO8)
LED_R: R5.2, R12.2, U1.21 (GPIO7)
unnamed: D1.2 (BK), R4.1
unnamed: D1.4 (GK), R10.1
unnamed: D1.3 (RK), R5.1
unnamed: J2.1, U2.7 (OUT+)
unnamed: J2.2, U2.9 (OUT-)
unnamed: J3.1, U6.7 (OUT+)
unnamed: J3.2, U6.9 (OUT-)
unnamed: J4.1, U5.7 (OUT+)
unnamed: J4.2, U5.9 (OUT-)
unnamed: J6.1, U10.7 (OUT+)
unnamed: J6.2, U10.9 (OUT-)
unnamed: R8.2, U1.5 (GPIO2/ADC1_CH2)
unnamed: TP4.1 (1_1), U1.30 (GPIO20/U0RXD)
unnamed: TP3.1 (1_1), U1.31 (GPIO21/U0TXD)
unnamed: C7.1, U2.1 (REG)
unnamed: U2.2 (SCL), U8.7 (SC1)
unnamed: U2.3 (SDA), U8.6 (SD1)
unnamed: C21.1, U5.1 (REG)
unnamed: U5.2 (SCL), U8.5 (SC0)
unnamed: U5.3 (SDA), U8.4 (SD0)
unnamed: C16.1, U6.1 (REG)
unnamed: U6.2 (SCL), U8.10 (SC2)
unnamed: U6.3 (SDA), U8.9 (SD2)
unnamed: C23.2, U7.9 (CAP)
unnamed: R19.2, U7.15 (S_SCL)
unnamed: R17.2, U7.16 (S_SDA)
unnamed: R29.2, U7.4 (~BOOT)
unnamed: R31.2, U8.3 (~RESET)
unnamed: C27.1, U10.1 (REG)
unnamed: U8.12 (SC3), U10.2 (SCL)
unnamed: U8.11 (SD3), U10.3 (SDA)
SCL: R28.2, TP8.1 (1_1), U1.18 (GPIO4/ADC1_CH4), U7.19 (H_SCL/SCLK/RX), U8.14 (SCL)
SDA: R23.2, TP6.1 (1_1), U1.19 (GPIO5/ADC2_CH0), U7.20 (H_SDA/MISO/TX), U8.15 (SDA)
USB_D+: U1.27 (GPIO19/USB_D+); also elsewhere on the board
USB_D-: U1.26 (GPIO18/USB_D-); also elsewhere on the board

Notes on the sheet:
I2C mux
IMU
MCU
Haptic feedback motor drivers
Addr = 0x70
Motor 3
PS0 = PS1 = LOW: I2C mode BOOT = HIGH: Operating mode (low = bootloader) SA0 = LOW <- HIGH: ADDR = 0x4A CLKSEL0 = HIGH, 1 = NC: internal clock
RGB LED
Motor 2
Press to enter download mode
R values based on ~equal brightness
Addr = 0x5A
Motor 1
Motor 4

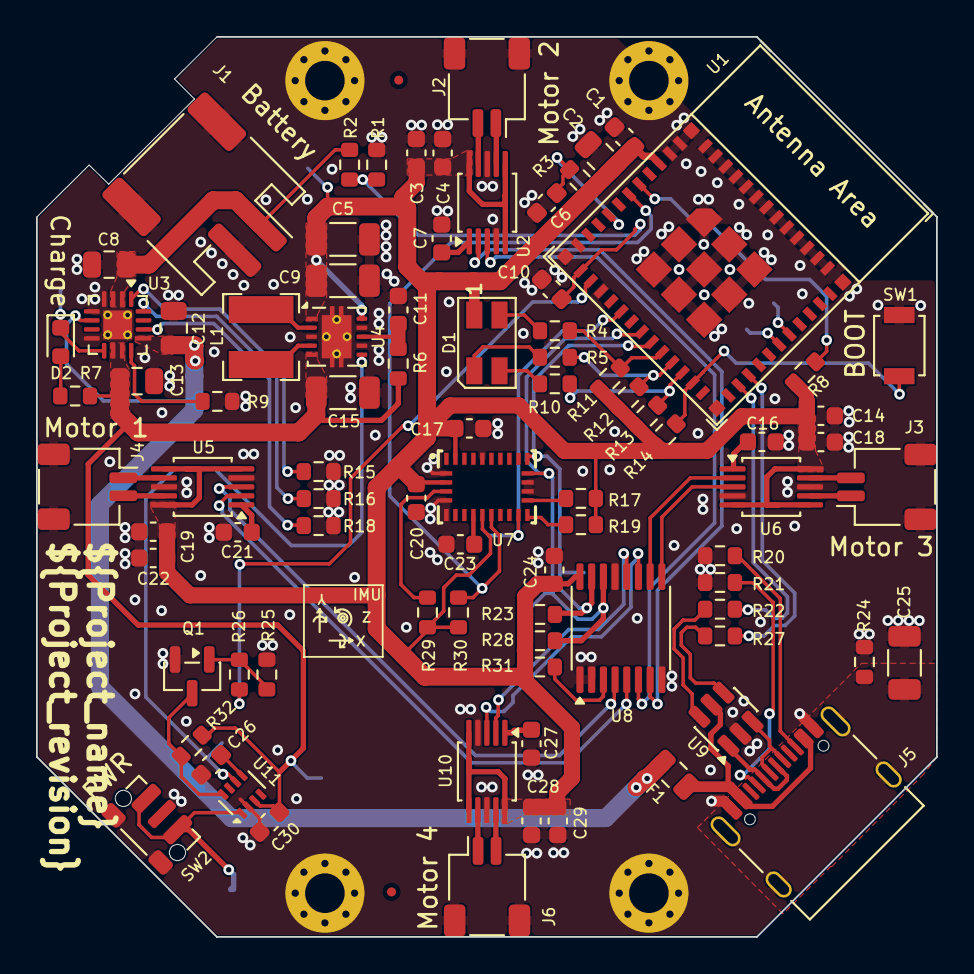
[picture p4: board stabielator.kicad_pcb from above]

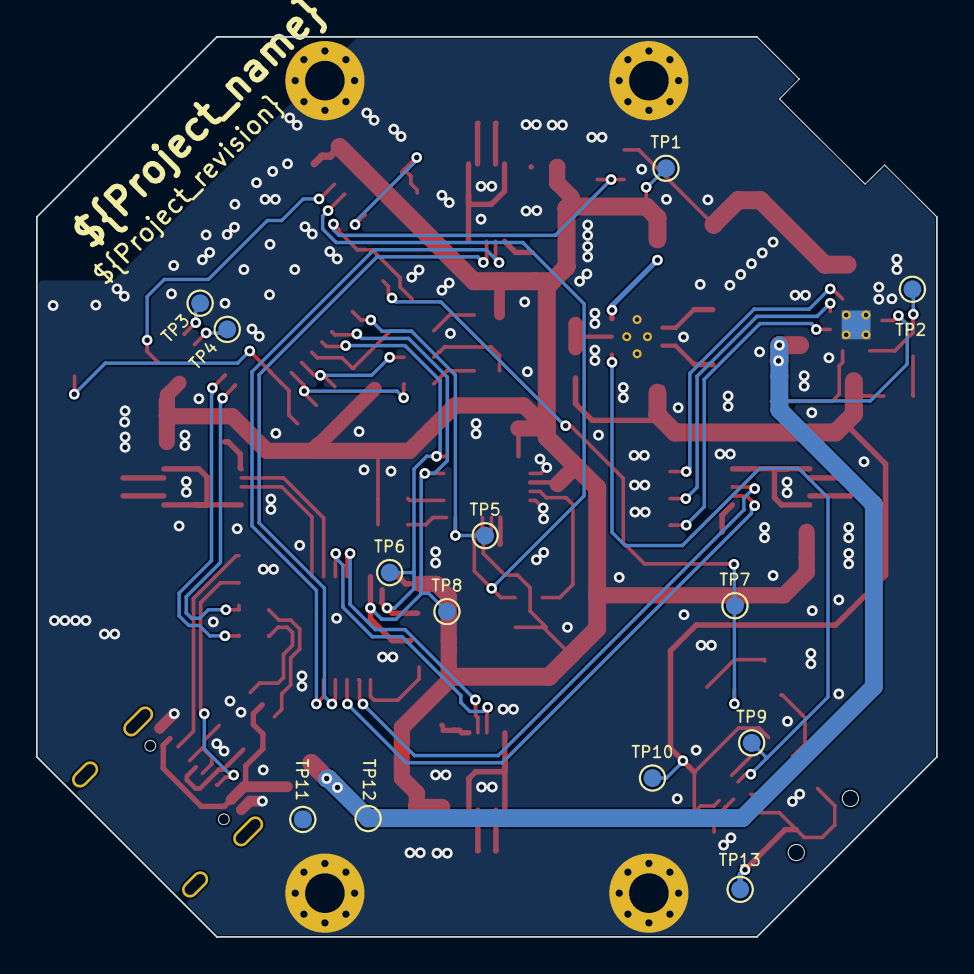
[picture p5: board stabielator.kicad_pcb from below]

Board: 4 copper layers, 50.0 x 50.0 mm, 106 parts (13 on the bottom side), 71 nets.

Other parts of the board:
SYM1: IMU_XYZ_Orientation
